sakibc/projectSuperLIMBinal/README.md

# Project SuperLIMBinal

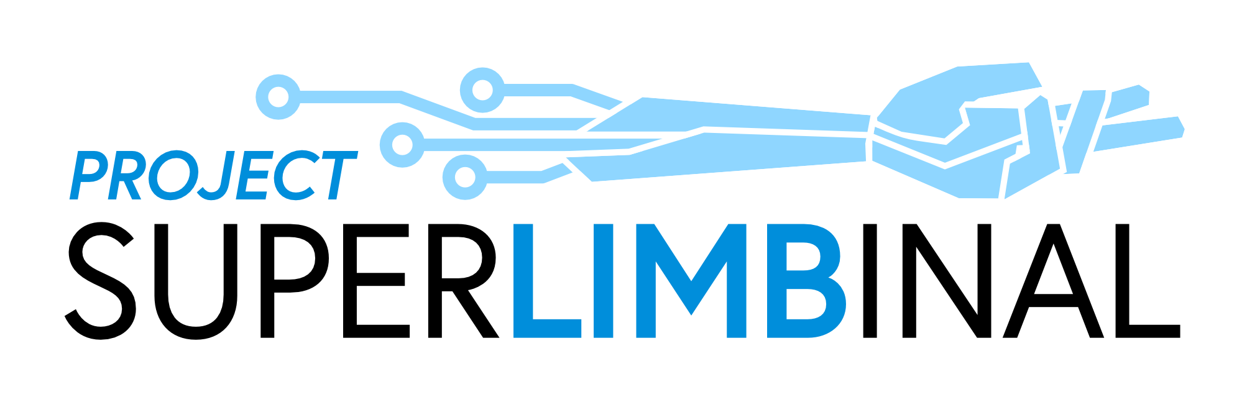
[picture p1: capstone_logo_v1.png]
