sakibc/projectSuperLIMBinal/inputStage-PC/frontend-dev/README.md

# superlimbinal-frontend

> A myoelectric control system powering a 3D-printable prosthetic arm. That you can notice.

## Build Setup

``` bash
# install dependencies
npm install

# serve with hot reload at localhost:8080
npm run dev

# build for production with minification
npm run build

# build for production and view the bundle analyzer report
npm run build --report
```

For a detailed explanation on how things work, check out the [guide](http://vuejs-templates.github.io/webpack/) and [docs for vue-loader](http://vuejs.github.io/vue-loader).
