sakibc/projectSuperLIMBinal/inputStage-hardware/subliminal1-sensor-board/subliminal1.brd

## EAGLE design inputStage-hardware/subliminal1-sensor-board/subliminal1.brd (2018-06-22)

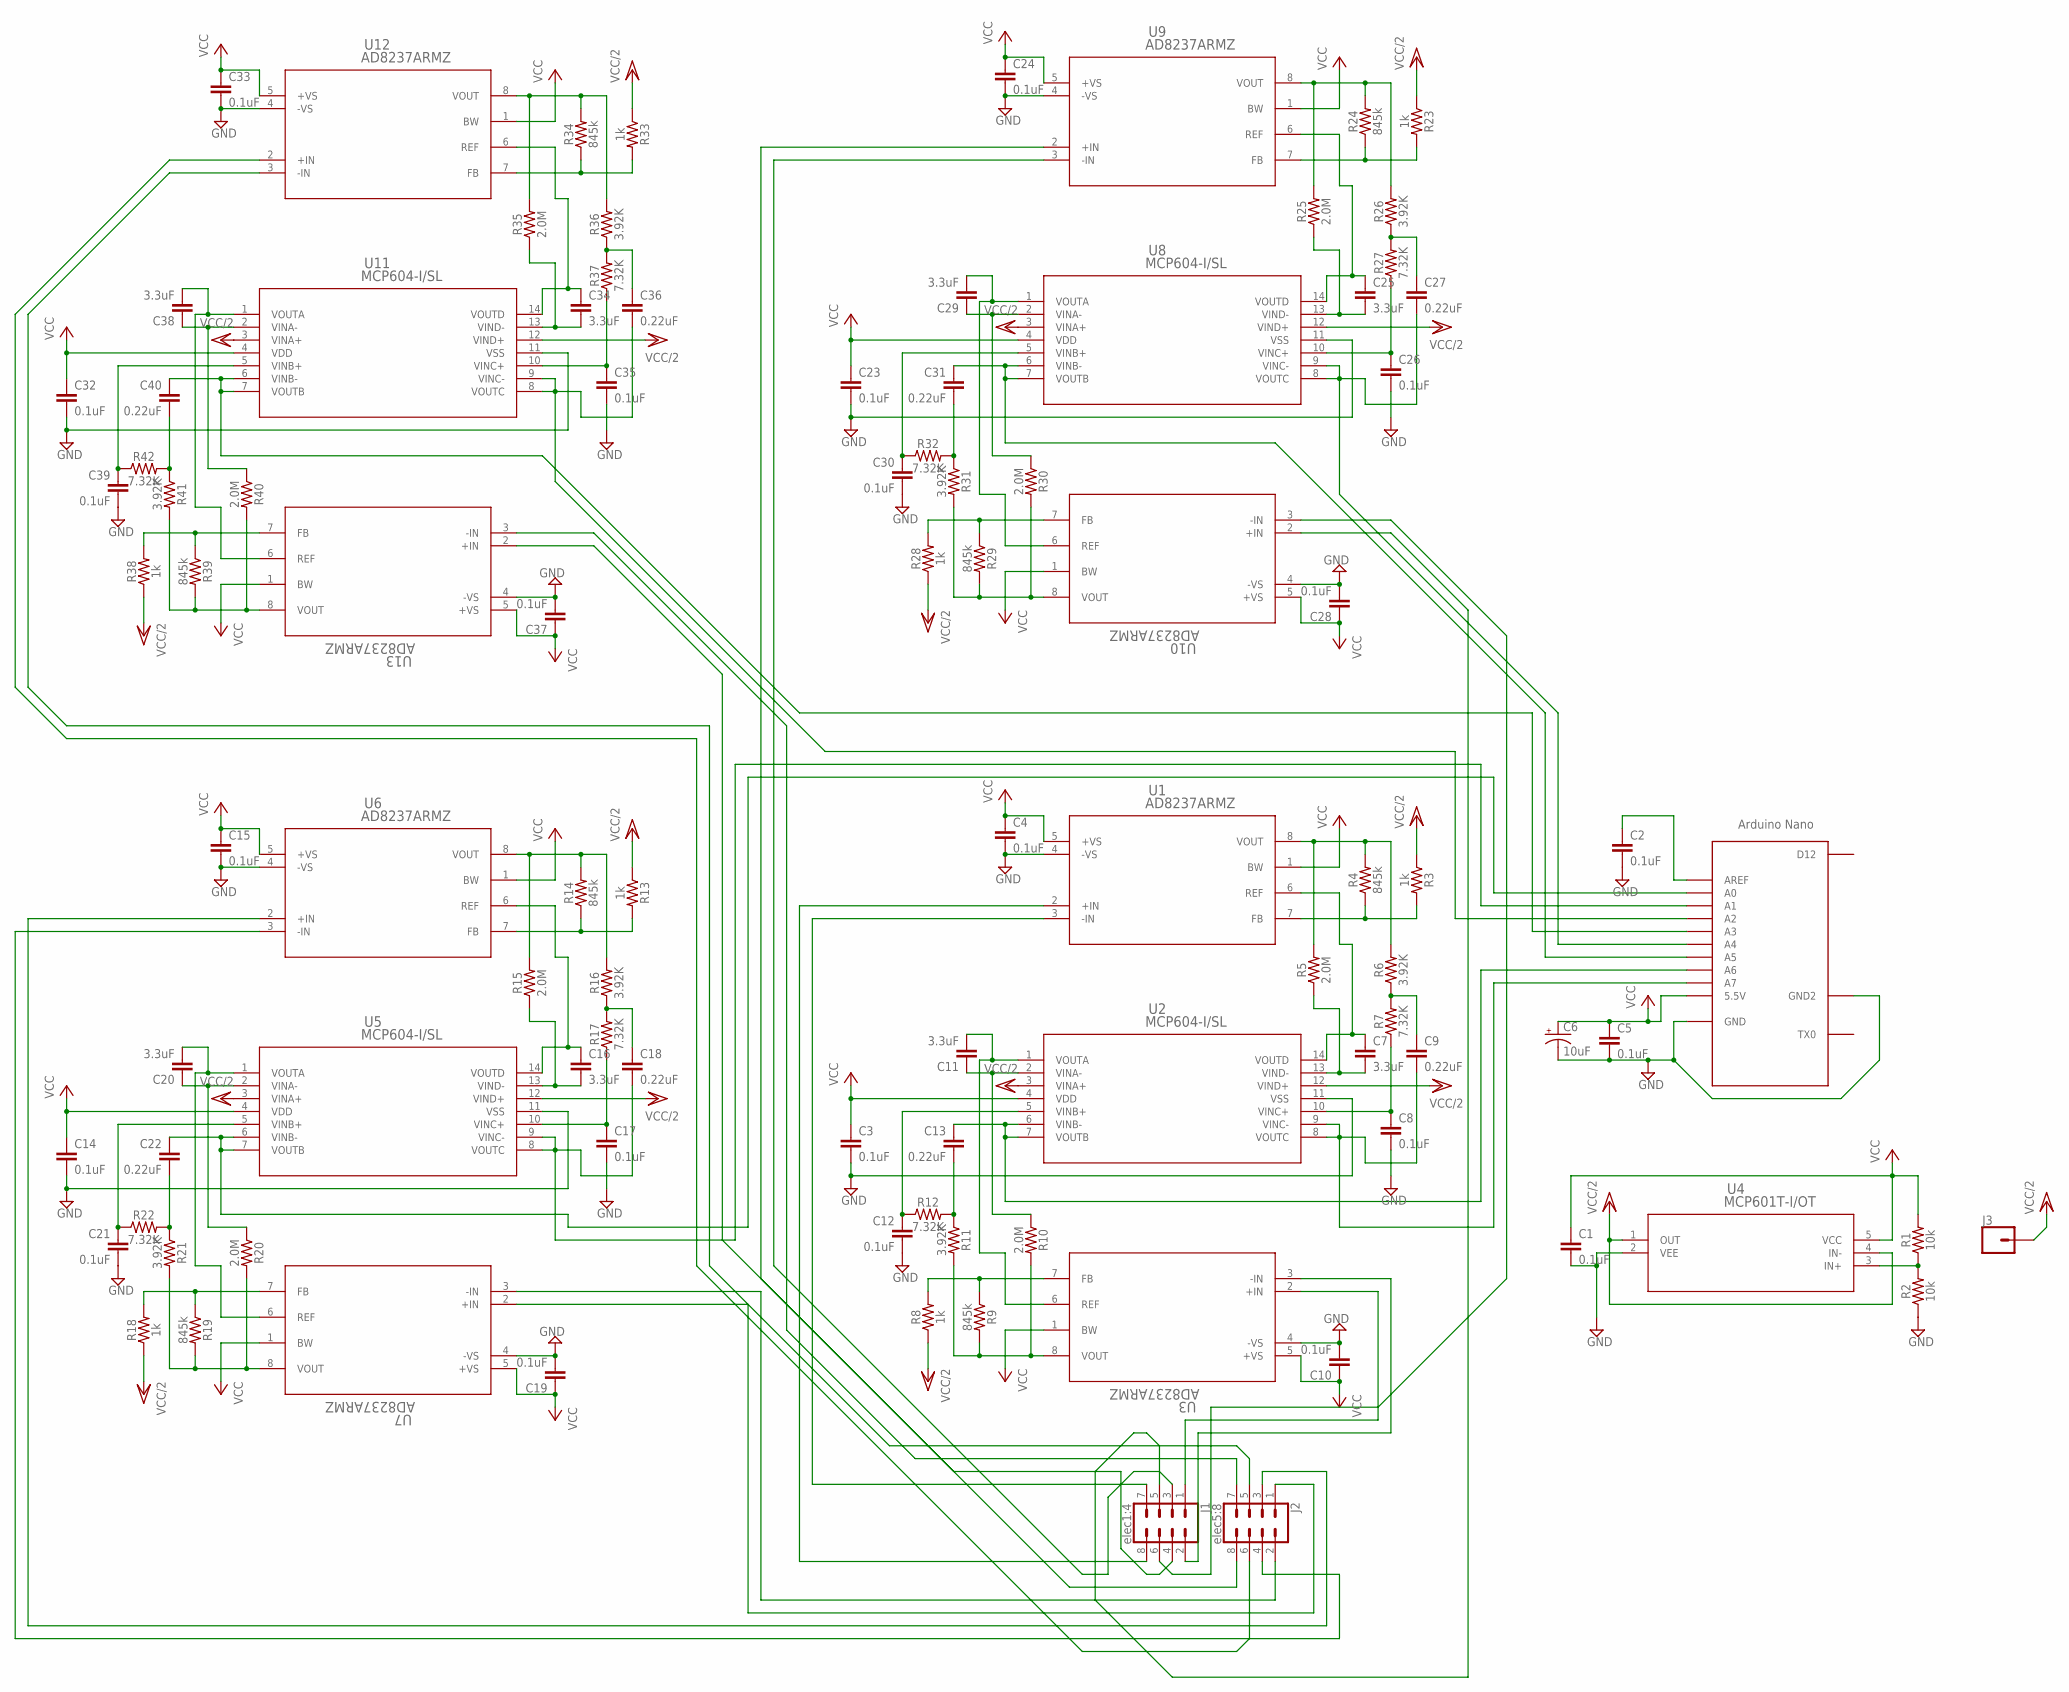
[picture p2: schematic subliminal1.sch]

Parts:
C1, C2, C3, C4, C5, C8, C10, C12, C14, C15, C17, C19, C21, C23, C24, C26, C28, C30, C32, C33, C35, C37, C39: 0.1uF; 0603
C6: 10uF; EIA3216
C7, C11, C16, C20, C25, C29, C34, C38: 3.3uF; 0603
C9, C13, C18, C22, C27, C31, C36, C40: 0.22uF; 0603
J1: elec1:4; 2X4
J2: elec5:8; 2X4
J3: CONN_01; 1X01
R1, R2: 10k; 0603
R3, R8, R13, R18, R23, R28, R33, R38: 1k; 0603
R4, R9, R14, R19, R24, R29, R34, R39: 845k; 0603
R5, R10, R15, R20, R25, R30, R35, R40: 2.0M; 0603
R6, R11, R16, R21, R26, R31, R36, R41: 3.92K; 0603
R7, R12, R17, R22, R27, R32, R37, R42: 7.32K; 0603
U1, U3, U6, U7, U9, U10, U12, U13: AD8237ARMZ; RM_8
U2, U5, U8, U11: MCP604-I/SL; SOIC14-N_MC
U4: MCP601T-I/OT; SOT-23-5_MC
U$1: ANALOG-NANO; ANANANOMIN

Connections:
GND: C1.2, C2.2, C3.2, C4.2, C5.2, C6.-, C8.2, C10.2, C12.2, C14.2, C15.2, C17.2, C19.2, C21.2, C23.2, C24.2, C26.2, C28.2, C30.2, C32.2, C33.2, C35.2, C37.2, C39.2, R2.1, U1.4 (-VS), U2.11 (VSS), U3.4 (-VS), U4.2 (VEE), U5.11 (VSS), U6.4 (-VS), U7.4 (-VS), U8.11 (VSS), U9.4 (-VS), U10.4 (-VS), U11.11 (VSS), U12.4 (-VS), U13.4 (-VS), U$1.GND, U$1.GND1 (GND2)
unnamed: C2.1, U$1.AREF
unnamed: R1.1, R2.2, U4.3 (IN+)
unnamed: R8.2, R9.1, U3.7 (FB)
unnamed: R9.2, R10.2, R11.2, U3.8 (VOUT)
unnamed: R4.2, R5.2, R6.2, U1.8 (VOUT)
unnamed: R3.2, R4.1, U1.7 (FB)
unnamed: C9.1, R6.1, R7.2
unnamed: C7.2, R5.1, U2.13 (VIND-)
unnamed: C7.1, U1.6 (REF), U2.14 (VOUTD)
unnamed: C8.1, R7.1, U2.10 (VINC+)
unnamed: R13.2, R14.1, U6.7 (FB)
unnamed: C13.1, U2.6 (VINB-), U2.7 (VOUTB), U$1.A6
unnamed: C11.2, U2.1 (VOUTA), U3.6 (REF)
unnamed: C13.2, R11.1, R12.2
unnamed: R14.2, R15.2, R16.2, U6.8 (VOUT)
unnamed: C16.2, R15.1, U5.13 (VIND-)
unnamed: C16.1, U5.14 (VOUTD), U6.6 (REF)
unnamed: C18.1, R16.1, R17.2
unnamed: C17.1, R17.1, U5.10 (VINC+)
unnamed: R18.2, R19.1, U7.7 (FB)
unnamed: C12.1, R12.1, U2.5 (VINB+)
unnamed: C9.2, U2.8 (VOUTC), U2.9 (VINC-), U$1.A7
unnamed: R19.2, R20.2, R21.2, U7.8 (VOUT)
unnamed: C11.1, R10.1, U2.2 (VINA-)
unnamed: C20.2, U5.1 (VOUTA), U7.6 (REF)
unnamed: C18.2, U5.8 (VOUTC), U5.9 (VINC-), U$1.A1
unnamed: C20.1, R20.1, U5.2 (VINA-)
unnamed: C22.1, U5.6 (VINB-), U5.7 (VOUTB), U$1.A0
unnamed: C22.2, R21.1, R22.2
unnamed: C21.1, R22.1, U5.5 (VINB+)
unnamed: R23.2, R24.1, U9.7 (FB)
unnamed: R24.2, R25.2, R26.2, U9.8 (VOUT)
unnamed: C25.2, R25.1, U8.13 (VIND-)
unnamed: C25.1, U8.14 (VOUTD), U9.6 (REF)
unnamed: C27.1, R26.1, R27.2
unnamed: C26.1, R27.1, U8.10 (VINC+)
unnamed: R28.2, R29.1, U10.7 (FB)
unnamed: R29.2, R30.2, R31.2, U10.8 (VOUT)
unnamed: C29.2, U8.1 (VOUTA), U10.6 (REF)
unnamed: C27.2, U8.8 (VOUTC), U8.9 (VINC-), U$1.A4
unnamed: C29.1, R30.1, U8.2 (VINA-)
unnamed: C31.1, U8.6 (VINB-), U8.7 (VOUTB), U$1.A5
unnamed: C31.2, R31.1, R32.2
unnamed: C30.1, R32.1, U8.5 (VINB+)
unnamed: R33.2, R34.1, U12.7 (FB)
unnamed: R34.2, R35.2, R36.2, U12.8 (VOUT)
unnamed: C34.2, R35.1, U11.13 (VIND-)
unnamed: C34.1, U11.14 (VOUTD), U12.6 (REF)
unnamed: C36.1, R36.1, R37.2
unnamed: C35.1, R37.1, U11.10 (VINC+)
unnamed: R38.2, R39.1, U13.7 (FB)
unnamed: R39.2, R40.2, R41.2, U13.8 (VOUT)
unnamed: C38.2, U11.1 (VOUTA), U13.6 (REF)
unnamed: C36.2, U11.8 (VOUTC), U11.9 (VINC-), U$1.A2
unnamed: C38.1, R40.1, U11.2 (VINA-)
unnamed: C40.2, R41.1, R42.2
unnamed: C39.1, R42.1, U11.5 (VINB+)
unnamed: J1.7, U1.3 (-IN)
unnamed: J1.8, U1.2 (+IN)
unnamed: J1.1, U3.2 (+IN)
unnamed: J1.4, U9.2 (+IN)
unnamed: J2.2, U7.3 (-IN)
unnamed: J2.1, U7.2 (+IN)
unnamed: J2.3, U6.2 (+IN)
unnamed: J2.4, U6.3 (-IN)
unnamed: J1.2, U3.3 (-IN)
unnamed: J1.3, U9.3 (-IN)
unnamed: J2.8, U13.2 (+IN)
unnamed: J2.7, U13.3 (-IN)
unnamed: J2.5, U12.3 (-IN)
unnamed: J2.6, U12.2 (+IN)
unnamed: J1.5, U10.2 (+IN)
unnamed: J1.6, U10.3 (-IN)
unnamed: C40.1, U11.6 (VINB-), U11.7 (VOUTB), U$1.A3
VCC: C1.1, C3.1, C4.1, C5.1, C6.+, C10.1, C14.1, C15.1, C19.1, C23.1, C24.1, C28.1, C32.1, C33.1, C37.1, R1.2, U1.1 (BW), U1.5 (+VS), U2.4 (VDD), U3.1 (BW), U3.5 (+VS), U4.5 (VCC), U5.4 (VDD), U6.1 (BW), U6.5 (+VS), U7.1 (BW), U7.5 (+VS), U8.4 (VDD), U9.1 (BW), U9.5 (+VS), U10.1 (BW), U10.5 (+VS), U11.4 (VDD), U12.1 (BW), U12.5 (+VS), U13.1 (BW), U13.5 (+VS), U$1.5V (5.5V)
VCC/2: J3.1, R3.1, R8.1, R13.1, R18.1, R23.1, R28.1, R33.1, R38.1, U2.3 (VINA+), U2.12 (VIND+), U4.1 (OUT), U4.4 (IN-), U5.3 (VINA+), U5.12 (VIND+), U8.3 (VINA+), U8.12 (VIND+), U11.3 (VINA+), U11.12 (VIND+)

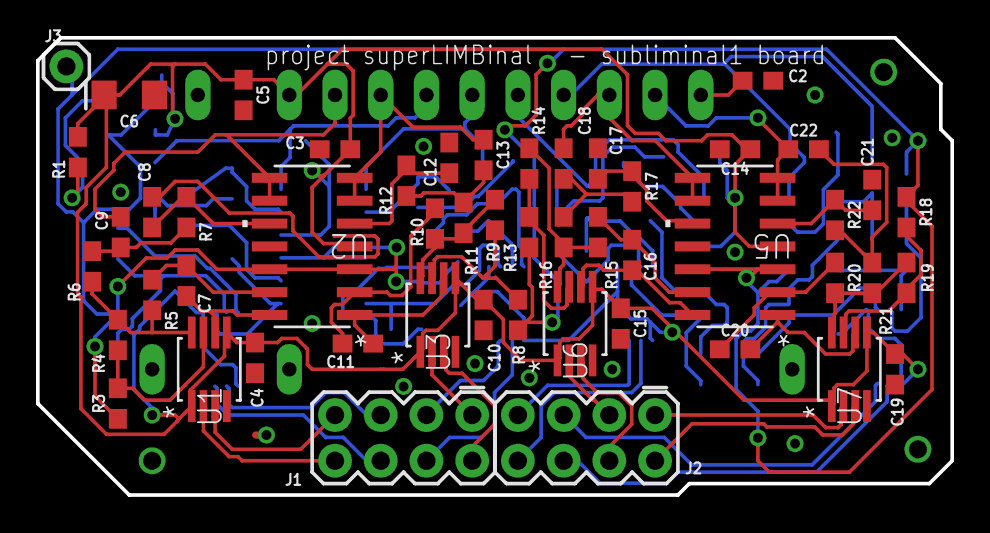
[picture p3: board subliminal1.brd from above]

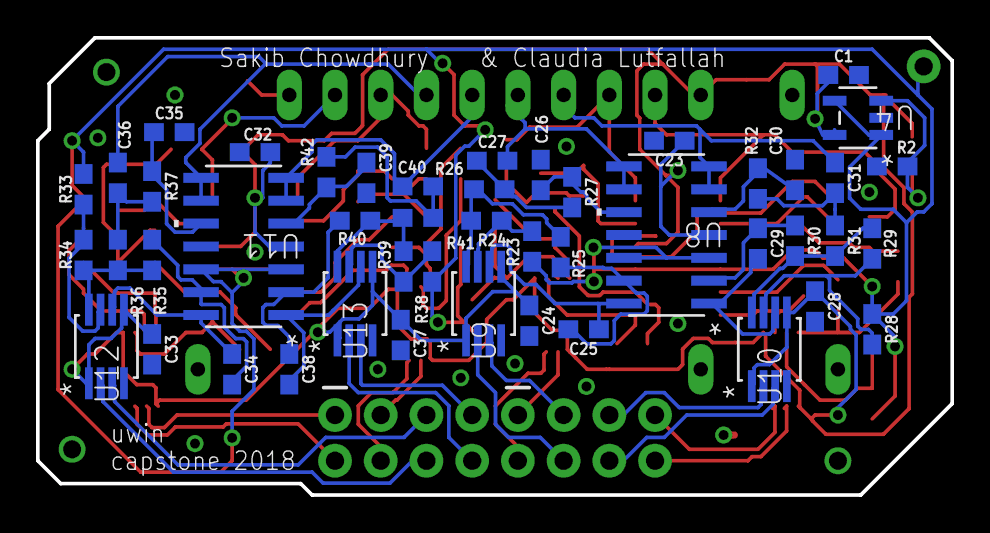
[picture p4: board subliminal1.brd from below]

Board: 2 copper layers, 50.8 x 25.4 mm, 99 parts (47 on the bottom side), 77 nets.
