sakibc/projectSuperLIMBinal/outputStage-arduino/outputStage-arduino.h

// Copyright 2018 Sakib Chowdhury and Claudia Lutfallah

#include <Arduino.h>

#define BAUDRATE 9600

#define THUMB   0
#define INDEX   1
#define MIDDLE  2
#define RING    3
#define PINKIE  4
#define WRIST   5
#define ELBOW   6
