sakibc/projectSuperLIMBinal/inputStage-PC/emgCapture.py

""" Copyright 2018 Sakib Chowdhury and Claudia Lutfallah
    
"""

import queue
import serial
import serial.tools.list_ports
import struct
import time

def getPort():
    ports = list(serial.tools.list_ports.comports())
    port = None

    for p in ports:
        if "CDC" in p[1]:  # let's just grab one and see what happens...
            port = p[0]
        elif "USB2.0-Serial" in p[1]:
            port = p[0]

    return port

def capture(q, deviceStatusq, port=None):
    """Capture data from Arduino in a separate process and push it to the queue.

    Keyword arguments:
    q -- the queue to push data to, 64 8-byte ints each time
    port -- the port to connect to, if unspecified it will be determined.
    """

    baudRate = 500000  # any slower and the Arduino can't send data fast enough

    # sampling rate overall is 16MHz/(32prescale*13cycles) ~= 38462
    # for each channel, at 8 channels is ~4808 Hz
    # we sample chunks 601 times per second

    attemptConnect = True   # keep trying to connect until the timeout limit
    timeout = 5             # is reached

    while attemptConnect:
        attemptConnect = False

        if port == None:
            port = getPort()
        try:
            with serial.Serial(port, baudRate, timeout=1, dsrdtr=True) as arduIn:

                print("Opening port", port+"...")

                startMessage = arduIn.readline().decode('utf-8')
                while ("Serial OK. Initializing..." in startMessage) != True:
                    startMessage = arduIn.readline().decode('utf-8')    # keep trying until we get what we want

                q.put("Connection established.")
                print(startMessage)

                capturing = True

                while capturing:
                    try:
                        rawdat = arduIn.read(64)
                        dat = struct.unpack('64B', rawdat)

                    except serial.SerialException:
                        print("Error: Connection lost.")
                        capturing = False
                        deviceStatusq.put(False)

                    except struct.error:
                        print("Error: Device sent invalid data.")
                        capturing = False
                        deviceStatusq.put(False)

                    else:
                        try:
                            q.put_nowait(dat)
                            # send captured data to the main process
                        except queue.Full:
                            pass    # if the queue's full, don't force it...

        except serial.SerialException:
            print("Error: Device not found.")
            q.put("error")  # so the main program knows the connection failed
        except KeyboardInterrupt:
            print("\nProgram execution interrupted.")
        except UnicodeDecodeError:  # this happens sometimes...
            print("Error: Device sent invalid data!")
            timeout -= 1
            if timeout >= 0:
                print("Retrying connection...")
                attemptConnect = True
            else:
                print("Invalid data received 5 times. Connection timed out.")
                q.put("error")
