sakibc/projectSuperLIMBinal/inputStage-PC/userGuide.py

""" Copyright 2018 Sakib Chowdhury and Claudia Lutfallah
    
"""
import time

def calibration():
    movements = ["Rest position","Open Hand","Close Hand","Pronate","Supinate"]

    time.sleep(5)

    for movement in movements:
        print("\nReady? Next movement:",movement)
        time.sleep(2)
        print('Begin Movement')
        time.sleep(2)
        print('Hold Position')
        time.sleep(3)
        print('Release')
        time.sleep(2)

    print('Calibration data set collection complete.\n')

def menuPrompt():
    print(
"""\nSuperLIMBinal sensor-stage interactive ready.
Please select an option:
(1) Calibrate
(2) Load existing calibration matrix
(3) Live synergy monitor
(4) Run test
(5) Exit\n""")

def endMessage():
    print("Thank you for choosing Project SuperLIMBinal.")
