sakibc/projectSuperLIMBinal/inputStage-PC/calibration.py

""" Copyright 2018 Sakib Chowdhury and Claudia Lutfallah

"""
import numpy as np
import multiprocessing as mp
import scipy.io
from sklearn.decomposition import NMF
import time
# import nimfa

import filterData
import userGuide

from helpers import clearQueue, reorder, saveData
from constants import *

def getCalibData(collectionTime, q, plotter, headless, server=None):
    dat = np.zeros((electrodeNum,collectionTime*Fs))

    plotter.startEmg()

    clearQueue(q)  # let's empty the queue first so we can grab some fresh data

    print("Starting data collection...")

    timer = 0

    for i in range(int(collectionTime*Fs/blockSamples)):
        sample = q.get(block=True)
        sample = reorder(sample)

        if headless:
            timer += 1
            if timer == 20:
                plotter.sendEmg(sample/256)
                timer = 0
        else:
            plotter.sendEmg(sample/256)

        index = i*blockSamples
        dat[:, (index):(index+blockSamples)] = sample

        if server != None and server.empty() == False:
            return None

    plotter.stopEmg()

    return dat

def calibrate(q, plotter, testmode=False, headless=False, server=None):
    W = np.ones((electrodeNum, synergyNum))
    print("Calibrating...")

    if testmode:
        caliData = scipy.io.loadmat(
            "../inputStage-analysis/test-data/set3.mat")['elecData']
        print("\nTest data loaded. Generating calibration matrix...")
    else:
        if headless == False:
            print("\nStarting calibration. Follow the instructions as they appear.")

            promptp = mp.Process(target=userGuide.calibration)
            promptp.start()

        time.sleep(5)  # give the user time to read...
        caliData = getCalibData(45, q, plotter, headless, server=server)   # capture 45 seconds of data
        
        if headless == False:
            promptp.join()

    print("Data capture finished.")

    if type(caliData) is np.ndarray:
        print("Data processing started.")
        # saveData(caliData)
        # print("Data successfully saved.")

        print("Prepping data...")

        pool = mp.Pool(8)

        startTime = time.time()
        # caliData = filterData.longPrep(caliData)

        caliData = np.array(pool.map(filterData.longPrep, caliData))

        endTime = time.time()

        pool.close()
        pool.join()

        timePassed = endTime - startTime
        print("Data prepped for analysis in", timePassed, 's.')

        timeStart = [(t+4)*Fs for t in range(0,45,9)]
        timeEnd = [t + 3*Fs for t in timeStart]

        # relaxed = caliData[:,timeStart[0]:timeEnd[0]]
        # baselines = np.mean(relaxed,-1)
        # maxes = np.ones(electrodeNum)

        # for i in range(8):  # normalize signals
        #     caliData[i,:] -= baselines[i]
        #     maxes[i] = (caliData[i, :]).max()
        #     caliData[i,:] /= maxes[i]

        # caliData = np.clip(caliData,0,1)

        # Z0 = caliData[:, 6000:45*Fs]
        # Z1 = caliData[:, 45*Fs:]

        # # Z0 = np.transpose(Z0)

        # snmf = nimfa.Snmf(Z0,rank=4,version='r',beta=1e-4)
        # W = snmf().basis()
        # print(W.shape)

        # if testmode:
        #     timeStart = [(t+8)*Fs for t in range(0, 45, 9)]
        # else:
        #     timeStart = [(t+4)*Fs for t in range(0,45,9)]

        # timeEnd = [t + 3*Fs for t in timeStart]

        relaxed = caliData[:,timeStart[0]:timeEnd[0]]
        baselines = np.mean(relaxed,-1)
        maxes = np.ones(electrodeNum)

        for i in range(8):  # normalize signals
            caliData[i,:] -= baselines[i]
            maxes[i] = (caliData[i, :]).max()
            caliData[i,:] /= maxes[i]

        caliData = np.clip(caliData,0,1)

        openData    = caliData[:, timeStart[1]:timeEnd[1]]
        closeData   = caliData[:, timeStart[2]:timeEnd[2]]
        proData     = caliData[:, timeStart[3]:timeEnd[3]]
        soupData    = caliData[:, timeStart[4]:timeEnd[4]]

        model = NMF(n_components=1,solver="mu") # solve for W matrix
        W0 = model.fit_transform(openData)
        H0 = model.components_

        W1 = model.fit_transform(closeData)
        H1 = model.components_

        W2 = model.fit_transform(proData)
        H2 = model.components_

        W3 = model.fit_transform(soupData)
        H3 = model.components_

        W = np.concatenate( # put it all together
            (W0*(H0[0]).max(), W1*(H1[0]).max(), W2*(H2[0]).max(), W3*(H3[0]).max()), axis=1)

        return (W, baselines, maxes)    # it works!
 
    else:
        return ("failed!", None, None)
