sakibc/projectSuperLIMBinal/(commit log)

2018-04-24 Finished Arduino code for 4 ADC inputs.
2018-04-28 Add defines for additional electrode numbers.
2018-04-30 got it graphing 8 electrodes fast enough...
2018-05-02 plot more data points each frame
2018-05-15 clean up calibration
2018-05-25 switch over from matplotlib to pyqtgraph and add saving
2018-05-27 updated smoothing filter for live view
2018-06-19 Added Arduino codes for output stage
2018-06-19 Work on sending data to motion stage
2018-06-19 Testing filters
2018-06-19 ignore one-time calibration data
2018-06-19 Correct typo in folder name
    [serial_communication.ino]
2018-06-20 Successfully send data between PC and Arduino to move a motor
2018-06-20 successfully send some muscle information to the arduino to move a motor
2018-06-22 Added schematic, board, and gerber files for sensor board
    [copper_bottom.gbr, copper_top.gbr, drills.xln, gerber_job.gbrjob, profile.gbr, silkscreen_bottom.gbr, silkscreen_top.gbr, soldermask_bottom.gbr]
2018-06-23 Added bill of materials for circuit board
2018-06-24 begin work on using adafruit servo shield
2018-06-28 start adding headless mode that skips gui
    [emgPlot.py, inputStage.py]
2018-06-29 fix "fix shutdown process"
    [webApp.py]
2018-06-29 fix "fix "fix shutdown""...
    [webApp.py]
2018-06-30 send connection status of sensor and motor stage
2018-07-14 attempt fix shutdown failure
    [webApp.py]
2018-07-15 re-enable check for pi and prepare for splitting of stages
2018-07-16 Started working on improving output stage
2018-07-17 added test for rate of sending samples
2018-07-18 modified output stage to test max and min pulselengths for servos
2018-07-18 make calibration more verbose and safe
2018-07-26 setup output stage
2018-07-26 Returned to only 8 electrodes
2018-07-26 fix bad monitor parameters
    [inputStage.py]
2018-07-27 added high-pass filter
2018-08-03 make calibration more robust
